hpalin2/SeniorDesignProject/(list of files, drawings)

Other design files:
boards/ECE 445 - Suction Sense PCB-1.dsn
