hpalin2/SeniorDesignProject/boards/ECE 445 - Suction Sense PCB-1.kicad_pcb

## KiCad design boards/ECE 445 - Suction Sense PCB-1.kicad_pcb (2025-11-09)

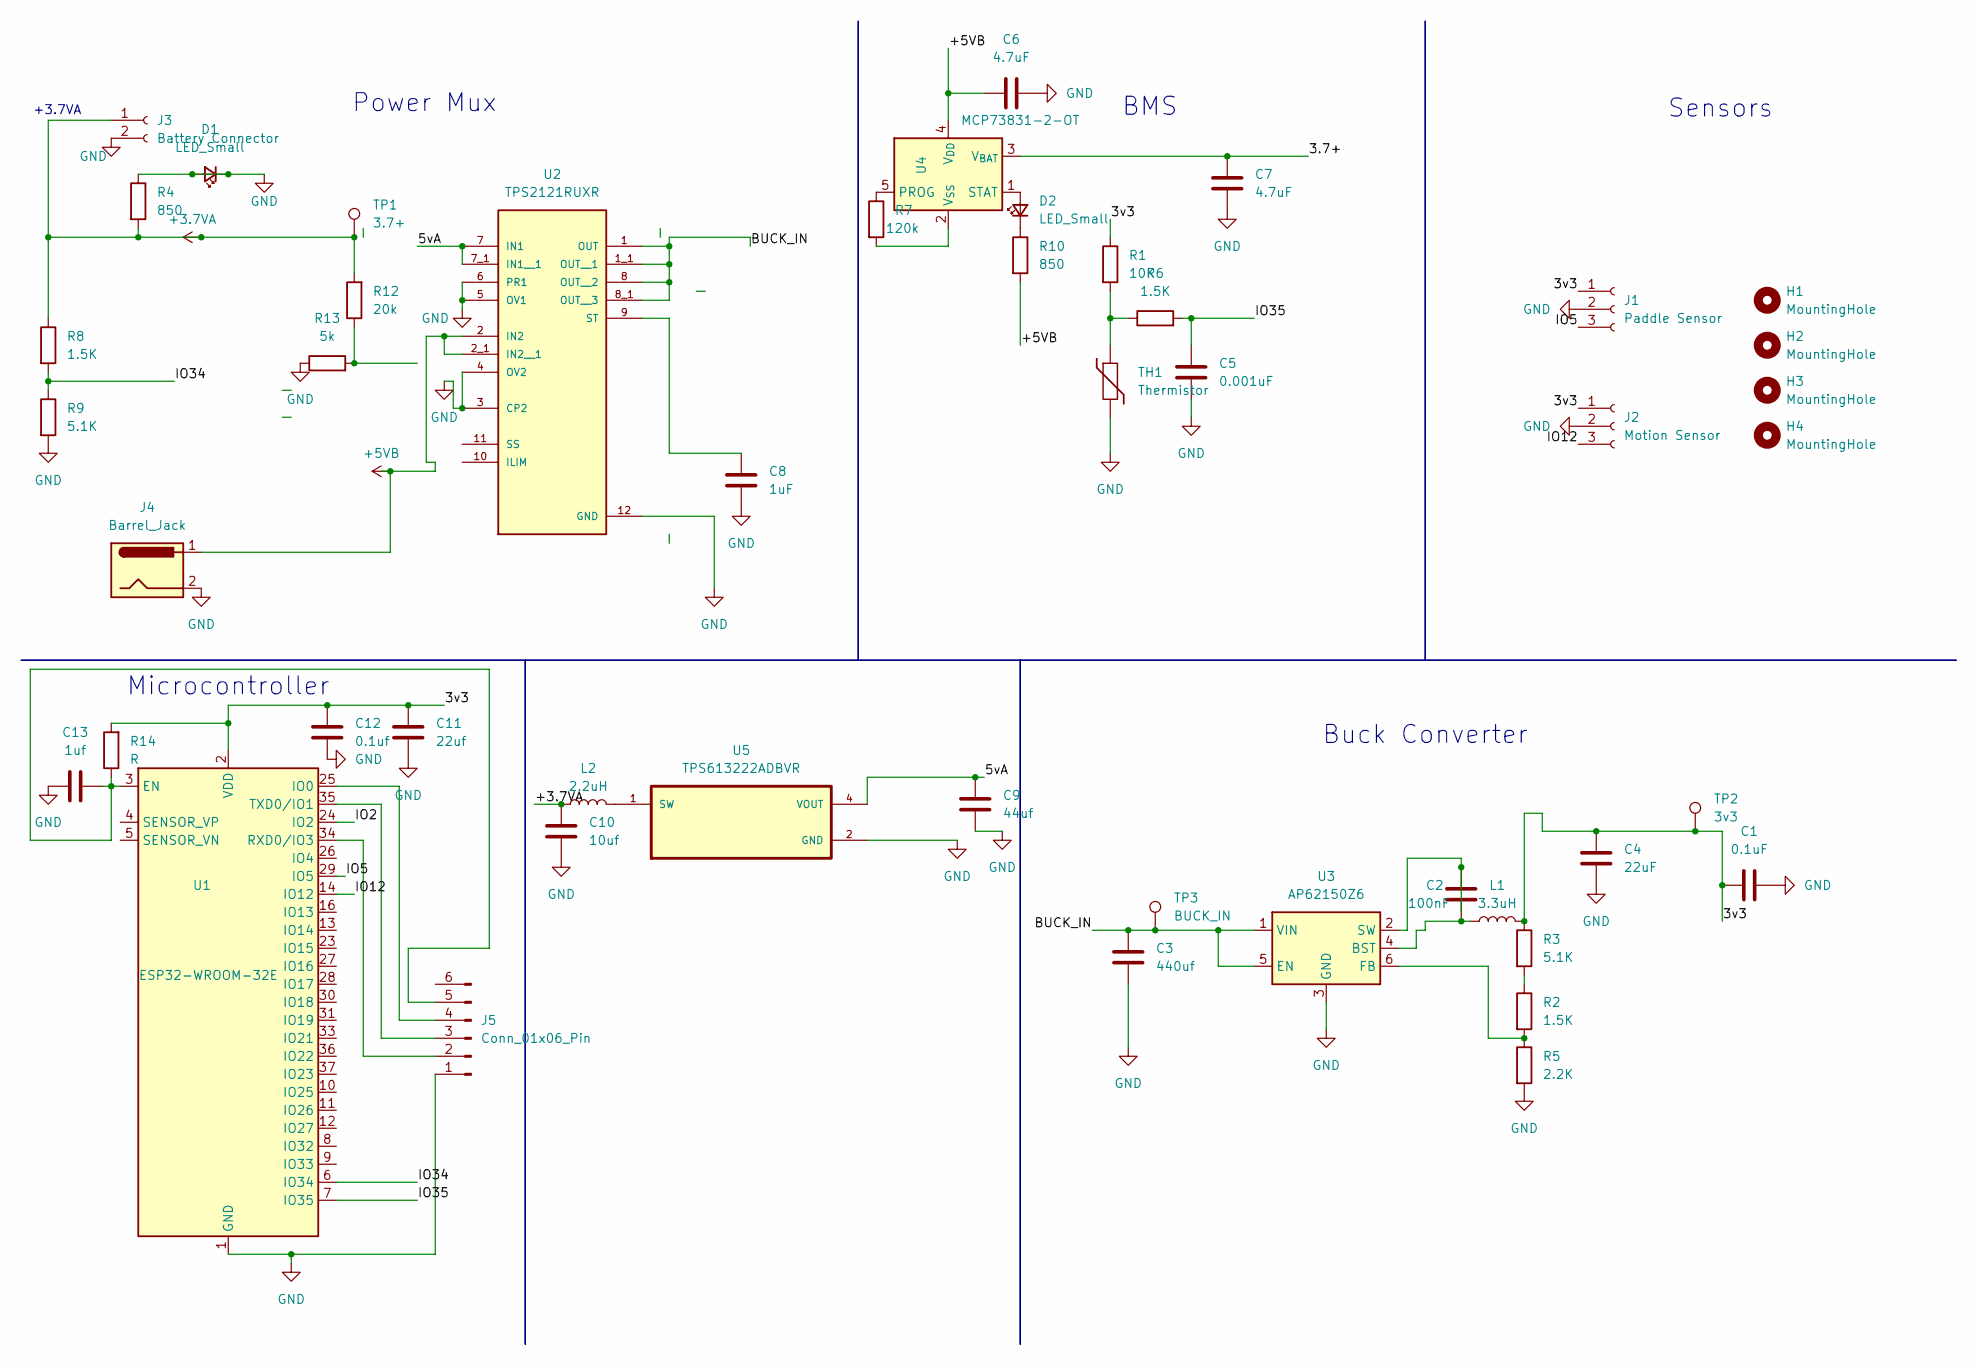
[picture p1: schematic ECE 445 - Suction Sense PCB-1.kicad_sch]

Parts:
C1: 0.1uF; CP_Elec_8x5.4
C2: 100nF; CP_Elec_8x5.4
C3: 440uf; CP_Elec_8x5.4
C4: 22uF; CP_Elec_8x5.4
C5: 0.001uF; CP_Elec_8x5.4
C6, C7: 4.7uF; C_0805_2012Metric_Pad1.18x1.45mm_HandSolder
C8: 1uF; C_0805_2012Metric_Pad1.18x1.45mm_HandSolder
C9: 44uf; C_0805_2012Metric_Pad1.18x1.45mm_HandSolder
C10: 10uf; C_0805_2012Metric_Pad1.18x1.45mm_HandSolder
C11: 22uf; C_0805_2012Metric_Pad1.18x1.45mm_HandSolder
C12: 0.1uf; C_0805_2012Metric_Pad1.18x1.45mm_HandSolder
C13: 1uf; C_0805_2012Metric_Pad1.18x1.45mm_HandSolder
D1, D2: LED_Small; LED_0805_2012Metric
H1, H2, H3, H4: MountingHole; MountingHole_3.2mm_M3
J1: Paddle Sensor; Molex_KK-254_AE-6410-03A_1x03_P2.54mm_Vertical
J2: Motion Sensor; Molex_KK-254_AE-6410-03A_1x03_P2.54mm_Vertical
J3: Battery Connector; BatteryHolder_Keystone_1057_1x2032
J4: Barrel_Jack; BarrelJack_CUI_PJ-036AH-SMT_Horizontal
J5: Conn_01x06_Pin; Molex_KK-396_A-41791-0006_1x06_P3.96mm_Vertical
L1: 3.3uH; L_Changjiang_FTC201655S
L2: 2.2uH; L_Changjiang_FTC201655S
R1: 10K; R_0508_1220Metric
R2, R6, R8: 1.5K; R_0508_1220Metric
R3, R9: 5.1K; R_0508_1220Metric
R4, R10: 850; R_0805_2012Metric_Pad1.20x1.40mm_HandSolder
R5: 2.2K; R_0508_1220Metric
R7: 120k; R_0805_2012Metric_Pad1.20x1.40mm_HandSolder
R12: 20k; R_0805_2012Metric_Pad1.20x1.40mm_HandSolder
R13: 5k; R_0805_2012Metric_Pad1.20x1.40mm_HandSolder
R14: R; R_0805_2012Metric_Pad1.20x1.40mm_HandSolder
TH1: Thermistor; R_0508_1220Metric
TP1: 3.7+; TestPoint_Pad_D2.0mm
TP2: 3v3; TestPoint_Pad_D2.0mm
TP3: BUCK_IN; TestPoint_Pad_D2.0mm
U1: ESP32-WROOM-32E; ESP32-WROOM-32D
U2: TPS2121RUXR; IC_TPS2121RUXR
U3: AP62150Z6; TSOT-23-6_HandSoldering
U4: MCP73831-2-OT; SOT-23-5
U5: TPS613222ADBVR; SOT95P280X145-5N

Connections:
+3.7VA: C10.1, J3.1, L2.1, R4.2, R8.1, R12.2, TP1.1
+5VB: C6.2, J4.1, R10.2, U2.2 (IN2), U2.2_1 (IN2__1), U4.4 (V_{DD})
/3.7+: C7.1, U4.3 (V_{BAT})
/3v3: C1.1, C4.1, C11.1, C12.1, J1.1, J2.1, L1.2, R1.1, R3.1, R14.2, TP2.1, U1.2 (VDD)
/5vA: C9.1, U2.7 (IN1), U2.7_1 (IN1__1), U5.4 (VOUT)
/BUCK_IN: C3.1, TP3.1, U2.1 (OUT), U2.1_1 (OUT__1), U2.8 (OUT__2), U2.8_1 (OUT__3), U3.1 (VIN), U3.5 (EN)
/IO2: U1.24 (IO2)
/IO5: J1.3, U1.29 (IO5)
/IO12: J2.3, U1.14 (IO12)
/IO34: R8.2, R9.1, U1.6 (IO34)
/IO35: C5.1, R6.2, U1.7 (IO35)
GND: C1.2, C3.2, C4.2, C5.2, C6.1, C7.2, C8.2, C9.2, C10.2, C11.2, C12.2, C13.1, D1.1 (K), D1.2 (A), J1.2, J2.2, J3.2, J4.2, J5.1, R4.1, R5.2, R9.2, R13.1, TH1.2, U1.1 (GND), U1.15 (GND), U1.38 (GND), U1.39 (GND), U2.3 (CP2), U2.4 (OV2), U2.5 (OV1), U2.6 (PR1), U2.12 (GND), U3.3 (GND), U5.2 (GND)
unnamed: D2.2 (A), U4.1 (STAT)
unnamed: D2.1 (K), R10.1
unnamed: J5.2, U1.34 (RXD0/IO3)
unnamed: J5.3, U1.35 (TXD0/IO1)
unnamed: J5.4, U1.25 (IO0)
unnamed: C13.2, J5.5, R14.1, U1.3 (EN)
unnamed: R1.2, R6.1, TH1.1
unnamed: R2.1, R3.2
unnamed: R12.1, R13.2
unnamed: C8.1, U2.9 (ST)
unnamed: C2.2, L1.1, U3.4 (BST)
unnamed: R2.2, R5.1, U3.6 (FB)
unnamed: C2.1, U3.2 (SW)
unnamed: R7.1, U4.5 (PROG)
unnamed: R7.2, U4.2 (V_{SS})
unnamed: L2.2, U5.1 (SW)

Notes on the sheet:
+3.7VA
BMS
Power Mux
Microcontroller
Buck Converter
Sensors

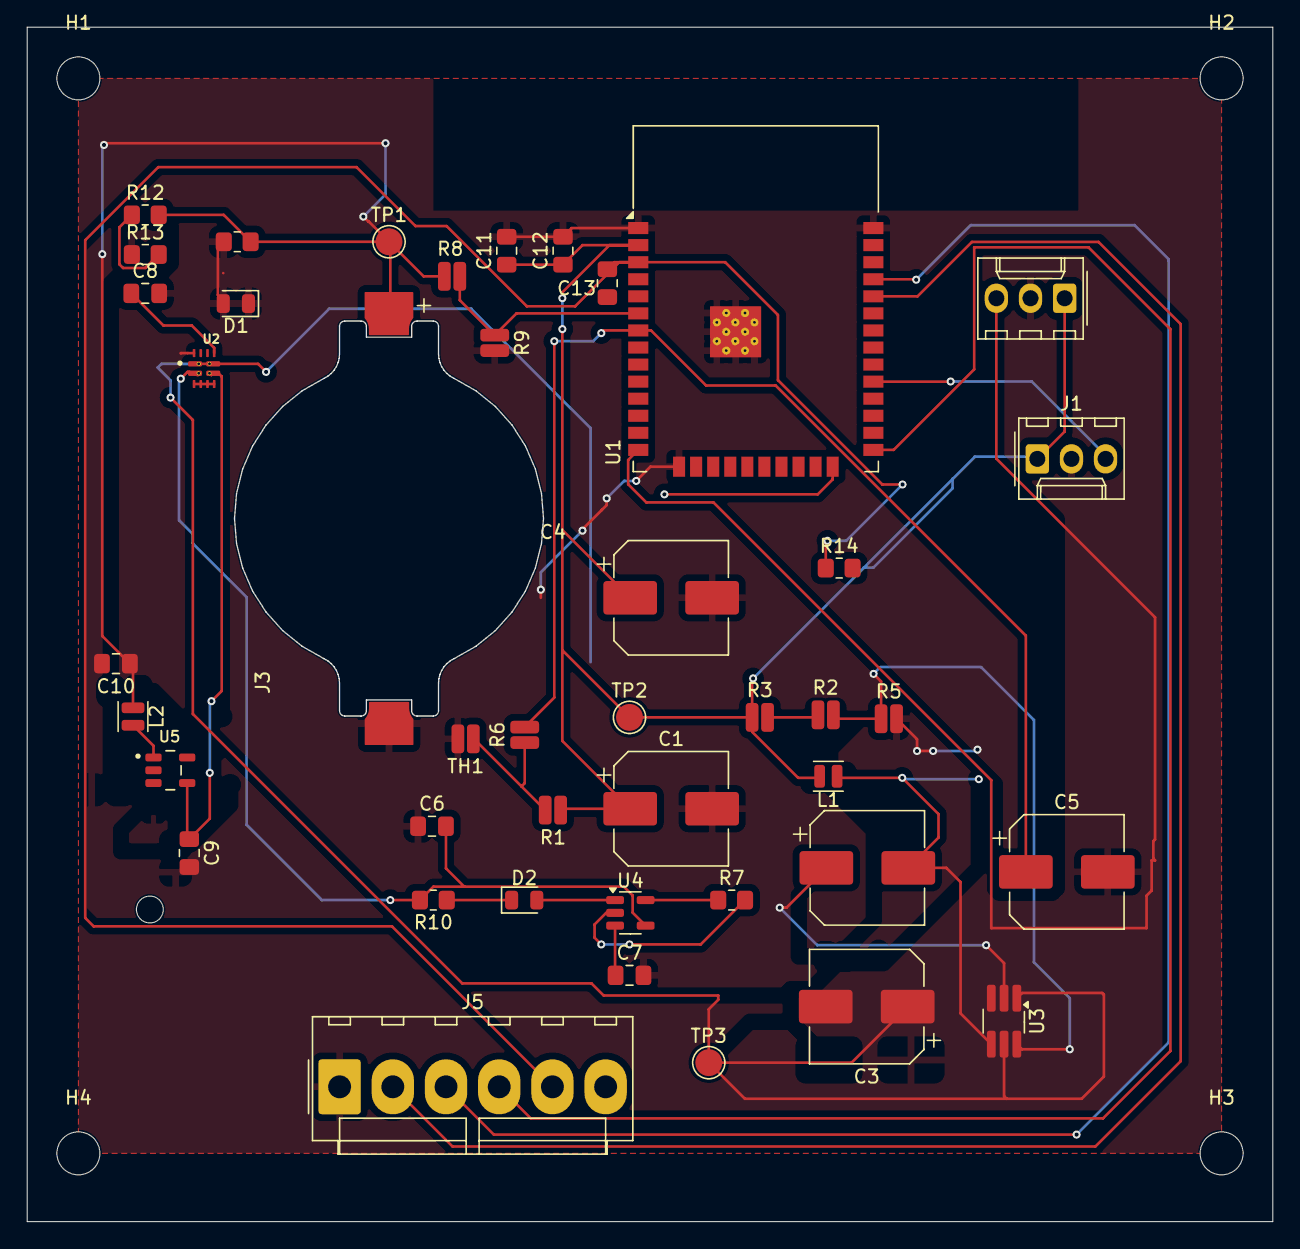
[picture p2: board ECE 445 - Suction Sense PCB-1.kicad_pcb from above]

Board: 2 copper layers, 92.7 x 88.9 mm, 48 parts (1 on the bottom side), 27 nets.
