hpalin2/SeniorDesignProject/webapp/src/util.cpp

#include "util.hpp"
#include <chrono>
#include <ctime>
#include <iomanip>
#include <sstream>

//helper to format timestamp for DB
std::string format_timestamp() {
    const auto now = std::chrono::system_clock::now();
    const std::time_t tt = std::chrono::system_clock::to_time_t(now);
    std::tm local_tm{};
#if defined(_WIN32)
    localtime_s(&local_tm, &tt);
#else
    localtime_r(&tt, &local_tm);
#endif
    std::ostringstream oss;
    oss << std::put_time(&local_tm, "%Y-%m-%d %H:%M:%S");
    return oss.str();
}
