hpalin2/SeniorDesignProject/(commit log)

2025-09-24 adding new project for pcb on the repository
    [suctionpcb.kicad_pcb, suctionpcb.kicad_sch]
2025-09-26 Worked on schematic - jeremy
    [ECE 445 - Suction Sense PCB.kicad_pcb, ECE 445 - Suction Sense PCB.kicad_sch]
2025-09-26 finished buck
    [ECE 445 - Suction Sense PCB.kicad_sch]
2025-09-26 Finished PCB Schematic
    [ECE 445 - Suction Sense PCB-1.kicad_pcb, ECE 445 - Suction Sense PCB-1.kicad_sch]
2025-09-26 adding changes and updated pcb just needs routing
    [ECE 445 - Suction Sense PCB-1.kicad_pcb, ECE 445 - Suction Sense PCB-1.kicad_sch]
2025-09-30 adding changes to the pcb finishing connections with power mux
    [ECE 445 - Suction Sense PCB-1.kicad_pcb]
2025-10-02 Changed voltage divider for powermux and also modified the buck converter Fb resistor network - Jeremy
    [ECE 445 - Suction Sense PCB-1.kicad_sch]
2025-10-03 finsih adding charging
    [ECE 445 - Suction Sense PCB-1.kicad_pcb, ECE 445 - Suction Sense PCB-1.kicad_sch]
2025-10-03 adding changes to the journal and pcb design, as well as adding the LED gnd connection on schematic
    [ECE 445 - Suction Sense PCB-1.kicad_pcb, ECE 445 - Suction Sense PCB-1.kicad_sch]
2025-10-03 adding changes need to update pcb with new package
    [ECE 445 - Suction Sense PCB-1-B_Cu.gbr, ECE 445 - Suction Sense PCB-1-B_Mask.gbr, ECE 445 - Suction Sense PCB-1-B_Silkscreen.gbr, ECE 445 - Suction Sense PCB-1-Edge_Cuts.gbr, ECE 445 - Suction Sense PCB-1-F_Cu.gbr, ECE 445 - Suction Sense PCB-1-F_Mask.gbr, ECE 445 - Suction Sense PCB-1-F_Silkscreen.gbr, ECE 445 - Suction Sense PCB-1-job.gbrjob]
2025-10-05 added gnd pour
    [ECE 445 - Suction Sense PCB-1.kicad_pcb]
2025-10-06 routed with new footprint
    [ECE 445 - Suction Sense PCB-1.kicad_pcb, ECE 445 - Suction Sense PCB-1.kicad_sch]
2025-10-08 adding new changes to pcb
    [ECE 445 - Suction Sense PCB-1-B_Cu.gbr, ECE 445 - Suction Sense PCB-1-B_Mask.gbr, ECE 445 - Suction Sense PCB-1-B_Silkscreen.gbr, ECE 445 - Suction Sense PCB-1-Edge_Cuts.gbr, ECE 445 - Suction Sense PCB-1-F_Cu.gbr, ECE 445 - Suction Sense PCB-1-F_Mask.gbr, ECE 445 - Suction Sense PCB-1-F_Silkscreen.gbr, ECE 445 - Suction Sense PCB-1-NPTH.drl]
2025-10-12 added boost converter
    [ECE 445 - Suction Sense PCB-1.kicad_pcb, ECE 445 - Suction Sense PCB-1.kicad_sch]
2025-10-13 added lined
    [ECE 445 - Suction Sense PCB-1.kicad_sch]
2025-10-16 adding changes to my notebook and adding the code I used to setup a basic html server using crow framework. Followed their instructions, couldn't get the mustache variable thing tho.
2025-10-18 adding my changes to webapp now we have a working database that pulls current OR schedules and updates our website
2025-10-23 ESP32 MQTT test working - Jeremy
2025-10-31 changed schematic and baord
    [ECE 445 - Suction Sense PCB-1-B_Cu.gbr, ECE 445 - Suction Sense PCB-1-B_Mask.gbr, ECE 445 - Suction Sense PCB-1-B_Silkscreen.gbr, ECE 445 - Suction Sense PCB-1-Edge_Cuts.gbr, ECE 445 - Suction Sense PCB-1-F_Cu.gbr, ECE 445 - Suction Sense PCB-1-F_Mask.gbr, ECE 445 - Suction Sense PCB-1-F_Silkscreen.gbr, ECE 445 - Suction Sense PCB-1-NPTH.drl]
2025-11-04 ESP32 updates application
2025-11-05 edit schematic
    [ECE 445 - Suction Sense PCB-1.csv, ECE 445 - Suction Sense PCB-1.kicad_pcb]
2025-11-07 Raspberry pi config
2025-11-07 Adding fixed working UI
    [repo.cpp, views.cpp]
2025-11-09 new baord
    [ECE 445 - Suction Sense PCB-1.kicad_pcb, ECE 445 - Suction Sense PCB-1.kicad_sch]
2025-11-09 better footprint for boost
    [ECE 445 - Suction Sense PCB-1.kicad_pcb, ECE 445 - Suction Sense PCB-1.kicad_sch]
2025-11-09 new upadtes to board
    [ECE 445 - Suction Sense PCB-1.kicad_pcb, ECE 445 - Suction Sense PCB-1.kicad_sch]
2025-11-16 Motion Sensor code for esp32
2025-12-01 Update project timeline with recent progress entries
    Added additional entries to the project timeline, detailing progress and issues encountered during the PCB design and testing phases, including component selection and circuit adjustments.
2025-12-09 Revise README with project milestones and updates
    Updated the README with detailed project logs and milestones, documenting the progress and challenges faced during the PCB design and integration process.
